EGR314-S-2026-202/EGR314-S-2026-202.github.io/docs/08-Resources/Resources.md

---
title: Resources
---

## CAD download files

### Concept Design

- [The Surveyor](../02-Concept-Design/CAD-models/EGR314-Surveyor.zip)
- [CropScout](../02-Concept-Design/CAD-models/A_WALLE.zip)

### 3D Printed Models

- [CropSCOUT Controller](../08-Resources/EGR314-Controller-Print.zip)
- [CropSCOUT Body](RoverBase.zip)
- [CropSCOUT Wheels and Temp/Humidity PCB Tower](PCB-Tower_T&H_W_Tower_CGE.SLDPRT)
- [CropSCOUT Full Assembly](CropScout%20ASMB_2023.zip)
- [Humidity Isolation Box](PCBholderbase.SLDPRT)
- [Humidity Isolation Box Lid](PCBLid.SLDPRT)
- [Temp Probe End Effector](endeff.SLDPRT)
- [PCB Retention Tab Large](bigcornerhold.SLDPRT)
- [PCB Retention Tab Small](cornerholdsmall.SLDPRT)
