EGR314-S-2026-202/EGR314-S-2026-202.github.io/docs/06-Prototype/Poster.pdf

### Embedded Systems Design Project II

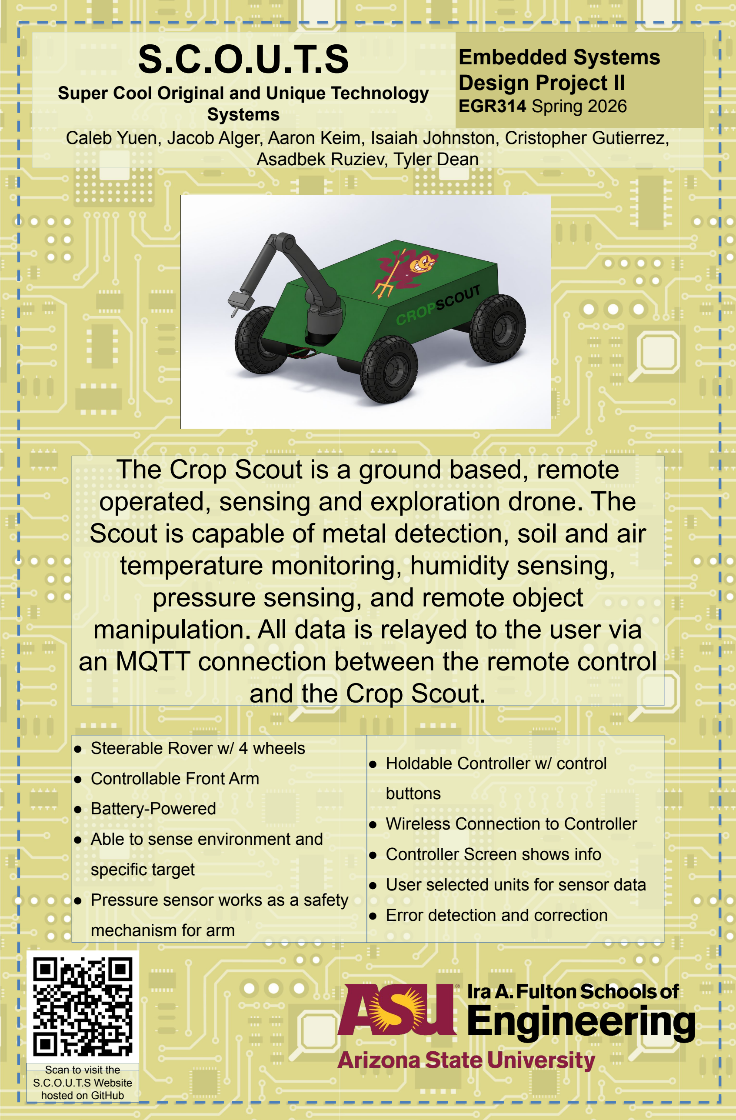
[picture p10: page 1]

EGR314 Spring 2026

# S.C.O.U.T.S

Super Cool Original and Unique Technology
Systems
Caleb Yuen, Jacob Alger, Aaron Keim, Isaiah Johnston, Cristopher Gutierrez, Asadbek Ruziev, Tyler Dean
- Steerable Rover w/ 4 wheels
- Controllable Front Arm
- Battery-Powered
- Able to sense environment and

specific target

- Pressure sensor works as a safety

mechanism for arm

## The Crop Scout is a ground based, remote operated, sensing and exploration drone. The Scout is capable of metal detection, soil and air

temperature monitoring, humidity sensing,

## pressure sensing, and remote object manipulation. All data is relayed to the user via an MQTT connection between the remote control

and the Crop Scout.

QR Code Here

Scan to visit the
S.C.O.U.T.S Website
hosted on GitHub
- Holdable Controller w/ control

buttons

- Wireless Connection to Controller
- Controller Screen shows info
- User selected units for sensor data
- Error detection and correction
