EGR314-S-2026-202/EGR314-S-2026-202.github.io/docs/05-Design-Review/design-review.md

---
title: Design Review
---

## External Design Review Team Presentation Video

Please view the video below to watch our design review where we cover our team organization, concept selection, product requirements, and team block diagram.

<iframe 
  width="800" 
  height="450"
  src="https://www.youtube.com/embed/wcsEIQijdIw"
  frameborder="0"
  allowfullscreen>
</iframe>

**External Design Review Team Presentation (Team 202) presented by Jacob Alger, Caleb Yuen, Aaron Kiem, Isaiah Johnston, Cristopher Gutierrez, Asadbek Ruziev & Tyler Dean**
