EGR314-S-2026-202/EGR314-S-2026-202.github.io/docs/04-Team-Block-Diagram/Team-Diagram.md

---
title: Block Diagram, Process Diagram, and Message Structure
---

## Team Block Diagram

Below is the Block Diagram we created as a team. We used the Daisy Chain format with 8-pin ribbon connectors to enable communication between all subsystems via UART and digital signals. There are two sections in our diagram: the rover section (on the right) and the controller section (on the left). It made sense to split the block diagrams this way, as the rover and the controller will be two separate modules that comprise the entire system. Both sections include Daisy Chain communication and will connect wirelessly via an MQTT server over Wi-Fi.

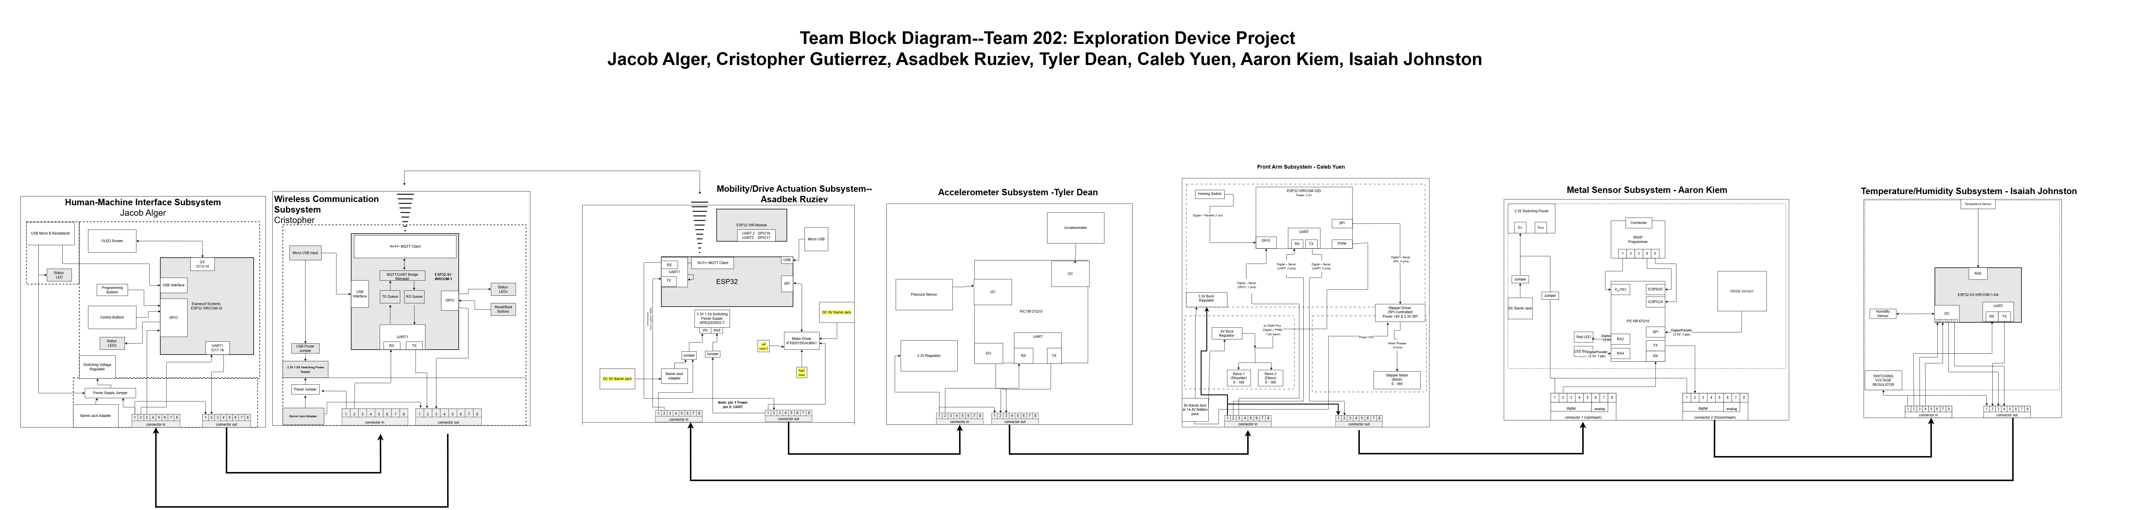
[picture p11: docs/04-Team-Block-Diagram/TBDV3.png]
Team Block Diagram


> You can view the Team Block Diagram as a PDF [here](TBDV3.draw.io.pdf) or via URL [here](https://viewer.diagrams.net/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)

## Communication Process Diagram

Below is the Communication Process Diagram, which details a couple of use cases for our system to help develop an understanding of how the user will interact with the device and how messages will be passed between subsystems. You can see that the user asks the controller to control the front arm and to change the temperature unit. This message is passed and acted upon by the system, going from system to system in the daisy chain. Then there is the loop section, which details what the rover is constantly doing independently of the user, such as using the pressure sensor to detect collisions with the arm.

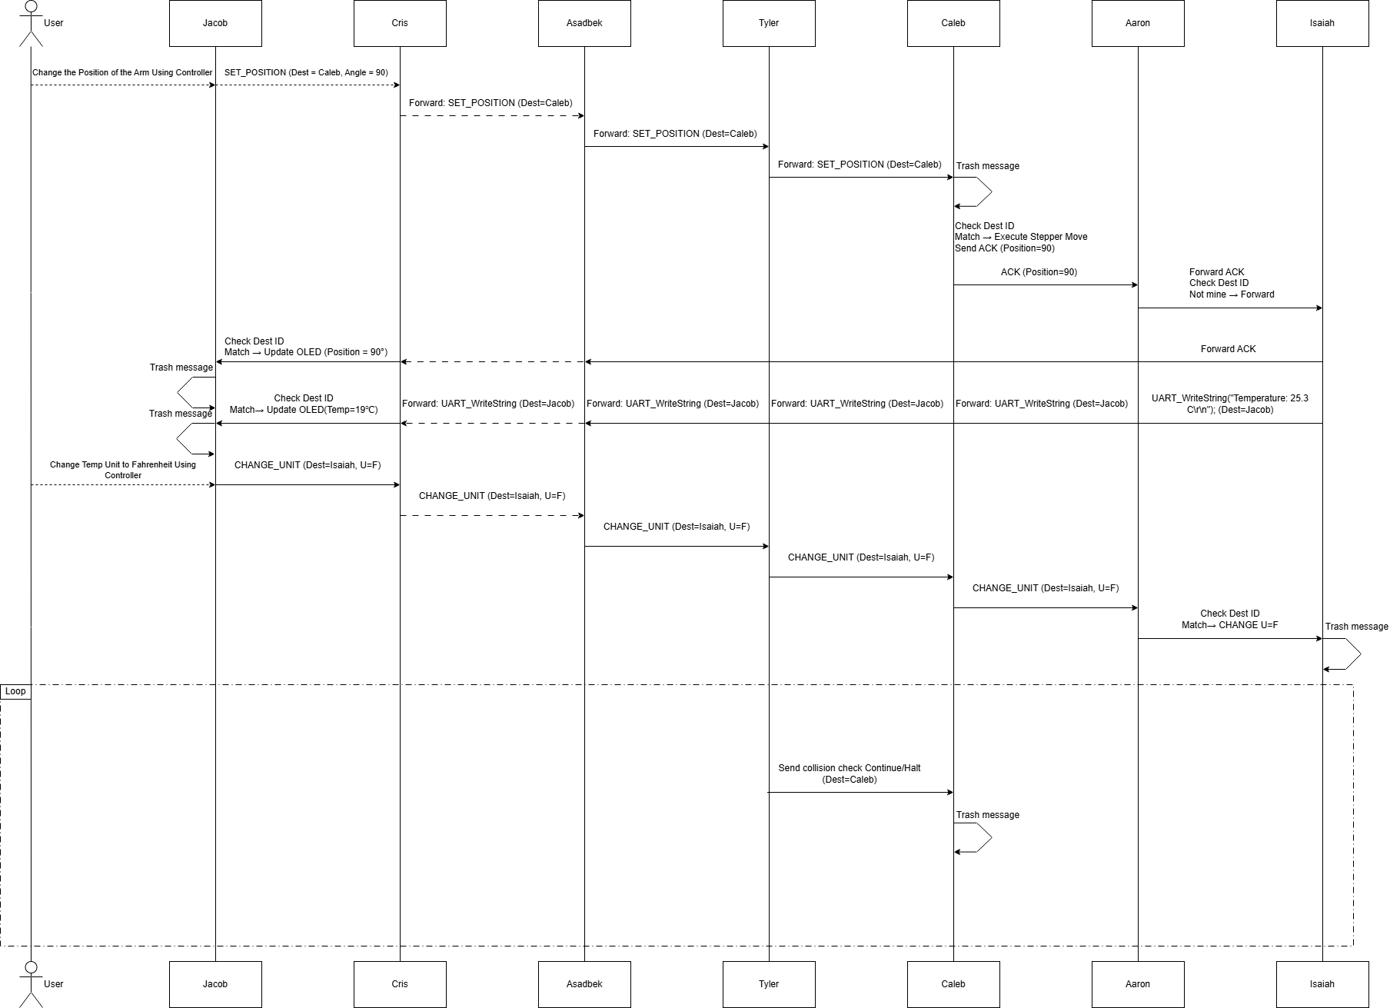
[picture p12: docs/04-Team-Block-Diagram/TSDV1.drawio.png]
Communication Process Diagram


> You can view the Communication Process Diagram as a PDF [here](TSDV1.drawio.pdf) or via URL [here](https://viewer.diagrams.net/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)

## Message Types
Below is a table of the types of messages that will be sent between our subsystems. Each type is given a number for better organization and understanding as to who is sending what kinds of messages.

| Number | Message Type | Description |
|---|---|---|
| 1 | Broadcast | The Broadcast Byte messages that go from anyone to everyone. |
| 2 | Wireless | Any message regarding wireless connection. |
| 3 | Wheels | Messages regarding the wheel subsystem. |
| 4 | Accelerometer  | Messages regarding the accelerometer/pressure sensor subsystem. |
| 5 | Arm | Messages regarding the front arm subsystem. |
| 6 | Temperature | Messages regarding the temperature sensor. |
| 7 | Humidity | Messages regarding the humidity sensor. |
| 8 | Metal | Messages regarding the metal detection subsystem. |

Below is a table detailing our team's full Application Programming Interface (API), showcasing every message with relevant information for each. Each message falls into one of the message types above. To learn more about the API, please review each teammate's individual datasheet and the "API" page for a comprehensive description.

| Source | Destination | Message Type | Message Name | Data Type | Message Data | Notes |
|---|---|---|---|---|---|---|
| HMI | Broadcast | 1 | Start Broadcast | String | Start | Sent to everyone; initiates system |
| HMI | Wheels | 3 | Wheel Drive Mode | String | F / B / R / L | Forward, Back, Right, Left |
| HMI | Pressure | 4 | Get Accelerometer | String | Read | Requests accelerometer reading |
| HMI | Arm | 5 | Arm Drive Mode | String | U / D / R / L | Up, Down, Right, Left |
| HMI | Metal Det.  | 8 | Metal Detector Read | String | Read | Requests metal detector reading |
| HMI | Temp/Hum. | 6 | Temperature Reading | String | Read | Requests temperature reading |
| HMI | Temp/Hum. | 6 | Temperature Unit Change | String | F / C | Switch between Fahrenheit and Celsius |
| HMI | Temp/Hum. | 7 | Humidity Reading | String | Read | Requests humidity reading |
| Communication | Wheels | 2 | BT Connection Check | String | check | Checks MQTT connection status |
| Temp/Hum. | HMI | 6 | Send Temperature | Float, String | -50–200, C / F | Two tokens; value and unit indicator |
| Temp/Hum. | HMI | 7 | Send Humidity | Float | 0–100 | Humidity percentage |
| Pressure | HMI | 4 | Send Accelerometer | Float | 0–100 | Accelerometer value |
| Pressure | Arm | 5 | Arm Clear Signal | Integer (8-bit)  | 00 / 01 | 00 = not clear, 01 = clear |
| Metal Det. | HMI | 8 | Metal Detector Relay | String | T / F | T = detected, F = not detected |
| Wheels | Comm. | 2 | BT Connection Reply | String | T / F | T = connected, F = not connected |
| Arm | HMI | 5 | Arm Position Ack. | Integer (16-bit) | -180–180 | Arm angle in degrees |
| Arm | HMI | 5 | Arm Status | String | Idle / Moving / Done / Halted | Current arm state |
| Arm | HMI | 5 | Arm Error | Integer (8-bit)  | 0–3 | Error code |

## Communication Sequence Functionality
The purpose of the communication diagram is to depict the interaction between the subsystems and the user's input. It satisfies the user's needs by handling the message input and passing it along the connection line. When a message reaches its designated subsystem, the subsystem interacts with the original input message and, if needed, outputs a response message, which is then sent down the chain to its targeted subsystem for output to the user.

An example of the communication structure follows this structure:
1) If the user presses a button on the HMI subsystem to raise the arm 
2) The HMI subsystem occupying the button would send a message out to the Arm subsystem, which is passed by other subsystems. 
3) The arm subsystem receives the message to raise its arm and would therefore raise its arm.
4) The arm subsystem trashes the original input message and outputs a position acknowledgment message targeting back to the HMI subsystem. 
5) That output message gets passed by the other subsystems and is received by the intended HMI subsystem.
6) The HMI subsystem would handle that message and therefore update its OLED screen for the user to see and trash the output message.
7) As a result, the user has the raise arm function carried out and is able to see verification that the OLED recognizes the position change.

## Message Structure
The design of the message outlines where the message came from (the source), who it's for (the destination), the variable associated with that message, the data type of that message, and the message related to that variable. A variable is connected with a colon, while additional variables are separated with a semicolon. A valid message would also start with AZ and end with YB. 

An example of a valid message would be AZthTV:F:75.256;TT:S:F;YB
- This is a message from the Temperature subsystem to the HMI subsystem, which calls for the temperature value as a float type and the temperature unit as a string with its corresponding values per variable.

## 5 Changes Post Software Proposal

1. We switched to MQTT instead of Bluetooth, so the Communication and Wheels subsystems had to both connect to the Wi-Fi, then the server, then the Comm system sent a handshake, which, once responded to by the Wheels, allowed the communication to start happening.

2. We changed the Start Broadcast to update the source in order to track where it was going. Originally, it would stay 'h' (from the HMI) the whole time, but now the HMI subsystem expects 't' to indicate that the message indeed reached the temperature/humidity subsystem.

3. The team experienced issues with reliably passing the broadcast message. A manual workaround was implemented to bypass the broadcast.

4. The arm subsystem sends position in steps, instead of degrees as originally planned.

5. All sensors were originally intended to have editable set points. This was never implemented.
