EGR314-S-2026-202/EGR314-S-2026-202.github.io/docs/01-Organization/Team-Organization.md

---
title: Team Organization
tags:
- tag1
---

## Team Charter

> S.C.O.U.T.S. is a group that focuses on communication, responsibility, and efficiency. We want to work together to make a high-quality product that we can all be proud of.

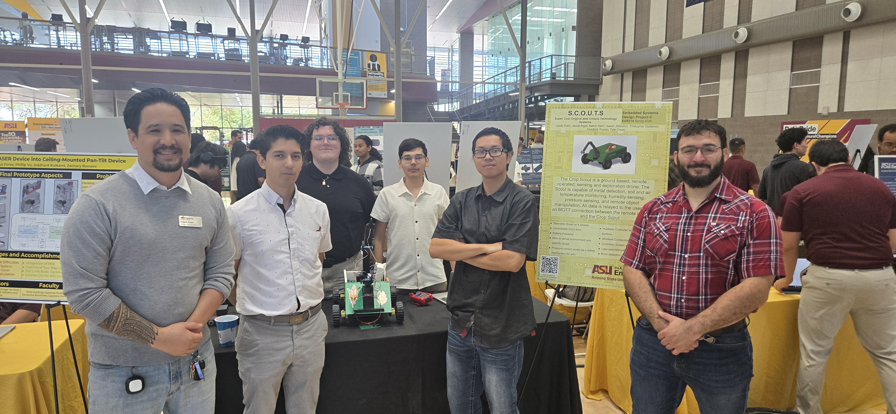
[picture p13: docs/01-Organization/Team_photo.jpg]
Team picture

>Team picture: From left to right: Caleb Yuen, Cristopher Gutierrez, Jacob Alger, Asadbek Ruziev, Aaron Kiem, Isaiah Johnston 

To create this Charter, the team sat down and discussed each individual's top 3 goals and qualities they want to achieve and demonstrate. Characterizing the Charter in this group setting ensured we all agreed on its content and the team's goals moving forward.

## Product Mission Statement

> S.C.O.U.T.S mission is to develop a modular exploration device that enables remote users to safely and expeditiously observe and interact with challenging environments through integrated sensing, actuation, and wireless communication.

To create this Mission Statement, we held a meeting to discuss the product's description and how we planned to achieve a successful outcome. We then boiled these ideas down to a single statement that accurately captures our desires for this product.

## Other Organizational Information

Other details about the organization structure of the team can be reviewed in ["Appendix: Team Organization Information."](https://egr314-s-2026-202.github.io/Appendix/01-Organization-Information/Append-Organization/)
