EGR314-S-2026-202/EGR314-S-2026-202.github.io/docs/06-Prototype/Showcase.md

---
title: Showcase
---

## Showcase Poster

Poster

>The pdf of the Poster can be dowloaded [*here*](Poster.pdf).

## Final Project Picture
Final Project Picture

## Showcase Video Demo

<p align="center">
  <iframe
    width="400"
    height="560"
    src="https://www.youtube.com/embed/YolZg2Wo9-o"
    frameborder="0"
    allowfullscreen>
  </iframe>
</p>

**Showcase demo narrated by Jacob Alger & Asadbek Ruziev**
