EGR314-S-2026-202/EGR314-S-2026-202.github.io/docs/04-Team-Block-Diagram/TBDV1.png

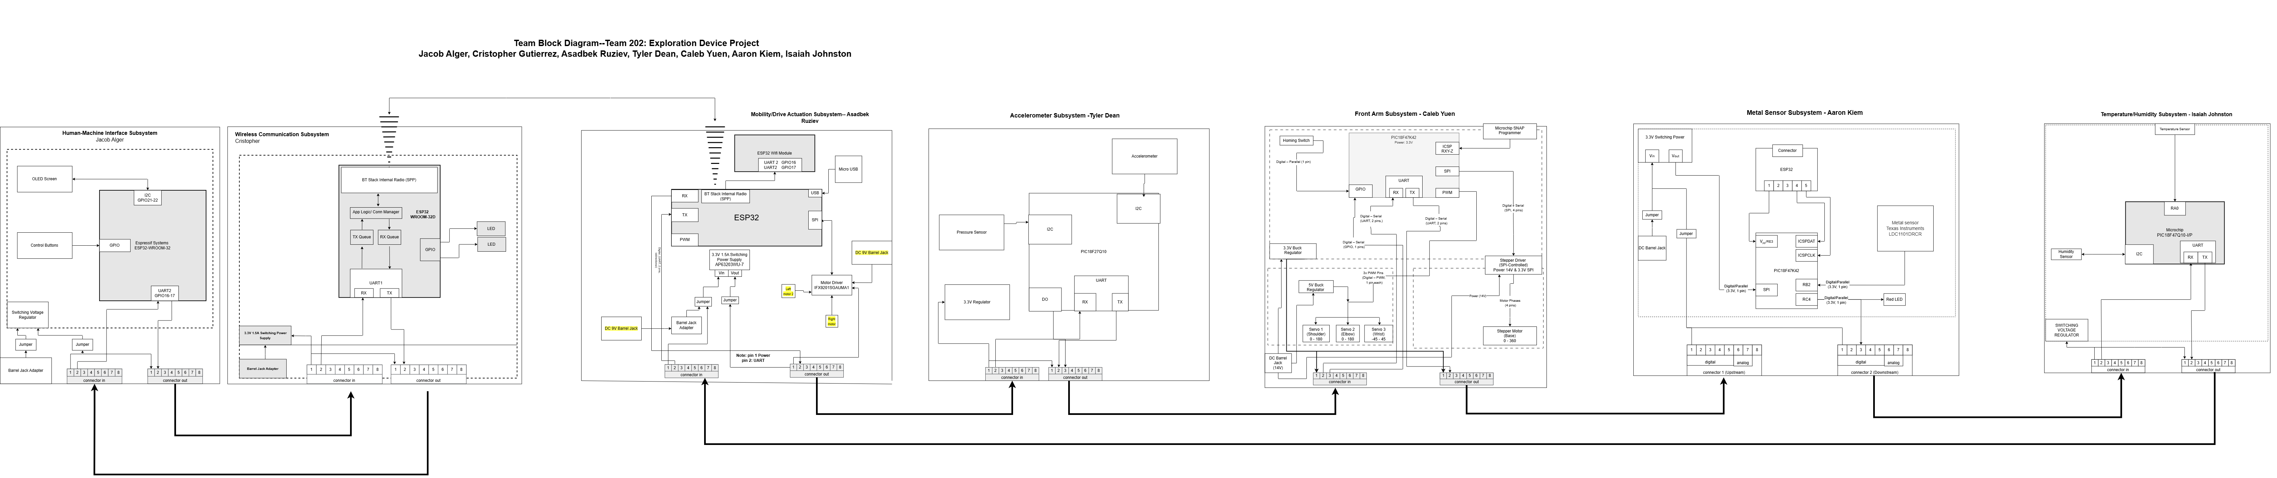
docs/04-Team-Block-Diagram/TBDV1.png
