EGR314-S-2026-202/EGR314-S-2026-202.github.io/docs/08-Resources/cornerholdsmall.SLDPRT

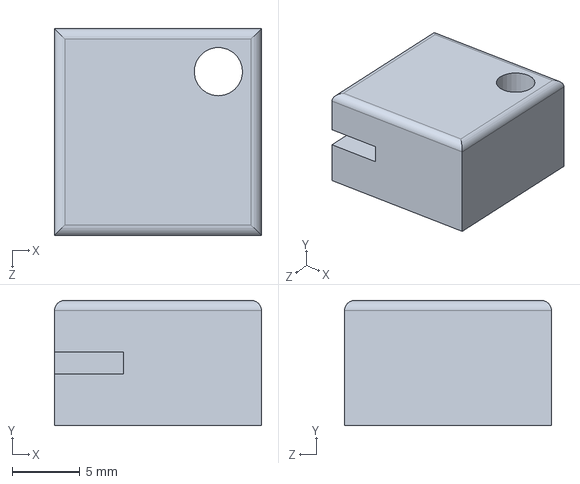
[picture p16: CAD file, 2026-05-05]
docs/08-Resources/cornerholdsmall.SLDPRT
15.2 x 9.22 x 15.2 mm
