EGR314-S-2026-202/EGR314-S-2026-202.github.io/docs/08-Resources/endeff.SLDPRT

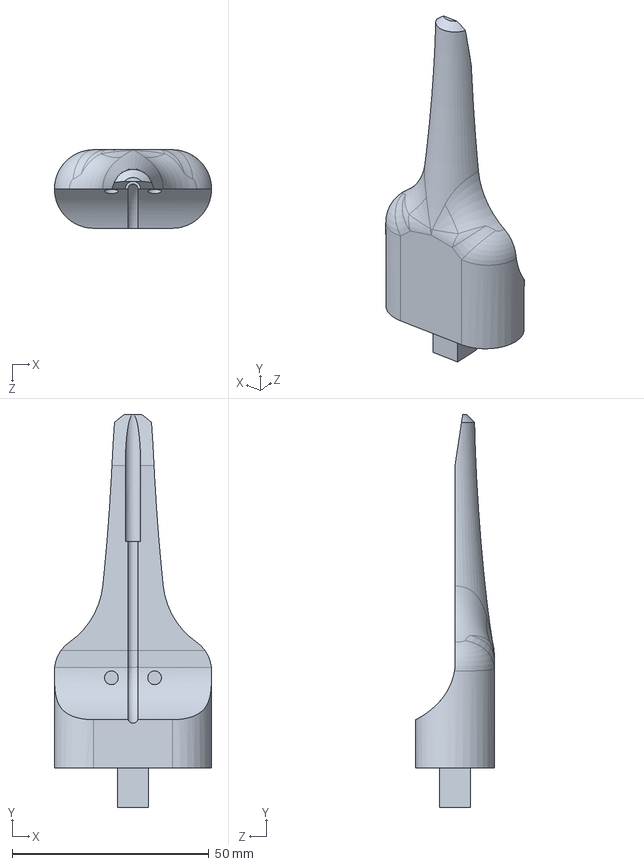
[picture p18: CAD file, 2026-05-05]
docs/08-Resources/endeff.SLDPRT
40.0 x 100.0 x 20.0 mm
