EGR314-S-2026-202/EGR314-S-2026-202.github.io/docs/08-Resources/PCBLid.SLDPRT

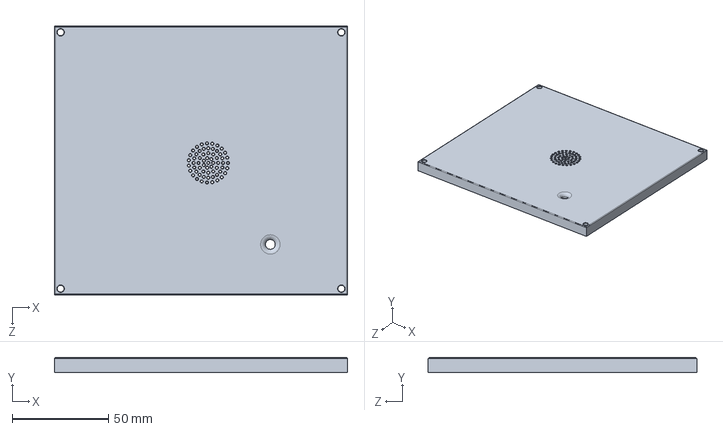
[picture p19: CAD file, 2026-05-05]
docs/08-Resources/PCBLid.SLDPRT
152.4 x 7.62 x 139.7 mm
