EGR314-S-2026-202/EGR314-S-2026-202.github.io/docs/08-Resources/PCBholderbase.SLDPRT

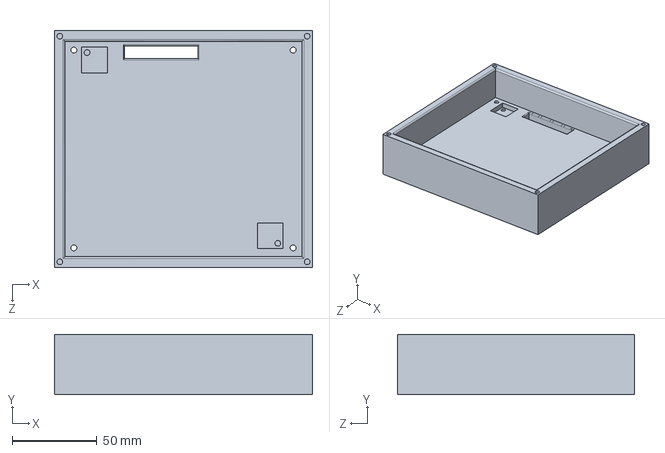
[picture p20: CAD file, 2026-05-05]
docs/08-Resources/PCBholderbase.SLDPRT
152.4 x 35.6 x 139.7 mm
