EGR314-S-2026-202/EGR314-S-2026-202.github.io/docs/08-Resources/PCB-Tower_T&H_W_Tower_CGE.SLDPRT

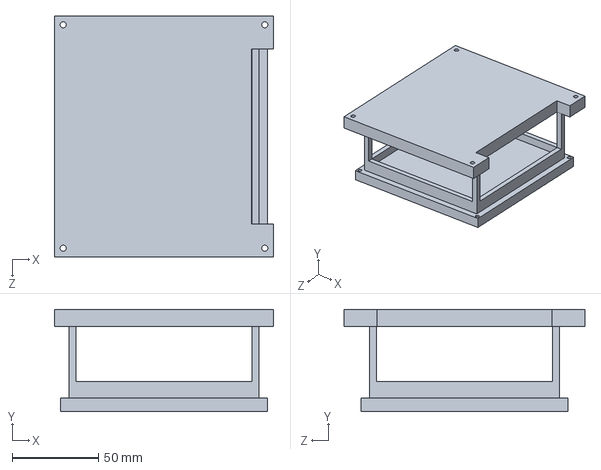
[picture p21: CAD file, 2026-05-05]
docs/08-Resources/PCB-Tower_T&H_W_Tower_CGE.SLDPRT
127.0 x 59.3 x 139.7 mm
