EGR314-S-2026-202/EGR314-S-2026-202.github.io/docs/02-Concept-Design/images/selected_C.pdf

# CROPSCOUT

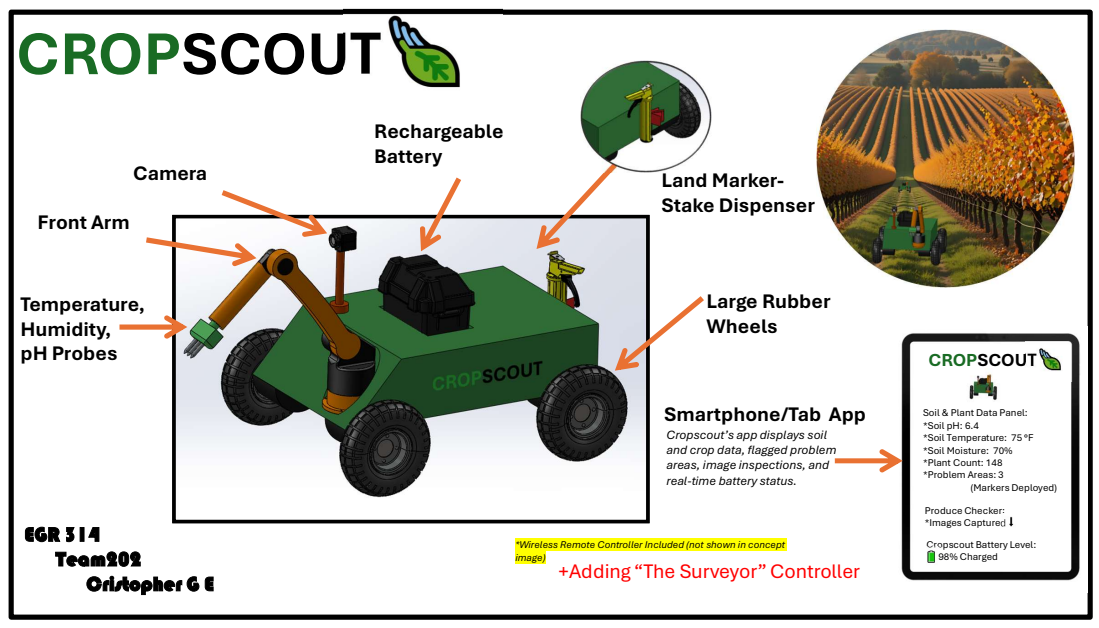
[picture p22: page 1]
CROPSCOUT; Camera; Rechargeable Battery; Land Marker-; Temperature, Humidity, pH Probes; Large Rubber Wheels; (Markers Deployed); EGR 314 Team202 Cristopher G E

Stake Dispenser Front Arm

Smartphone/Tab App
Cropscout’s app displays soil
and crop data, flagged problem
areas, image inspections, and
real-time battery status.

Soil & Plant Data Panel:
*Soil pH: 6.4
*Soil Temperature: 75 °F
*Soil Moisture: 70%
*Plant Count: 148
*Problem Areas: 3

Produce Checker:
*Images Captured
Cropscout Battery Level:
98% Charged

*Wireless Remote Controller Included (not shown in concept
image)
+Adding “The Surveyor” Controller
