EGR314-S-2026-202/EGR314-S-2026-202.github.io/docs/02-Concept-Design/images/EGR314-Surveyor-Concept.pdf

# THE SURVEYOR

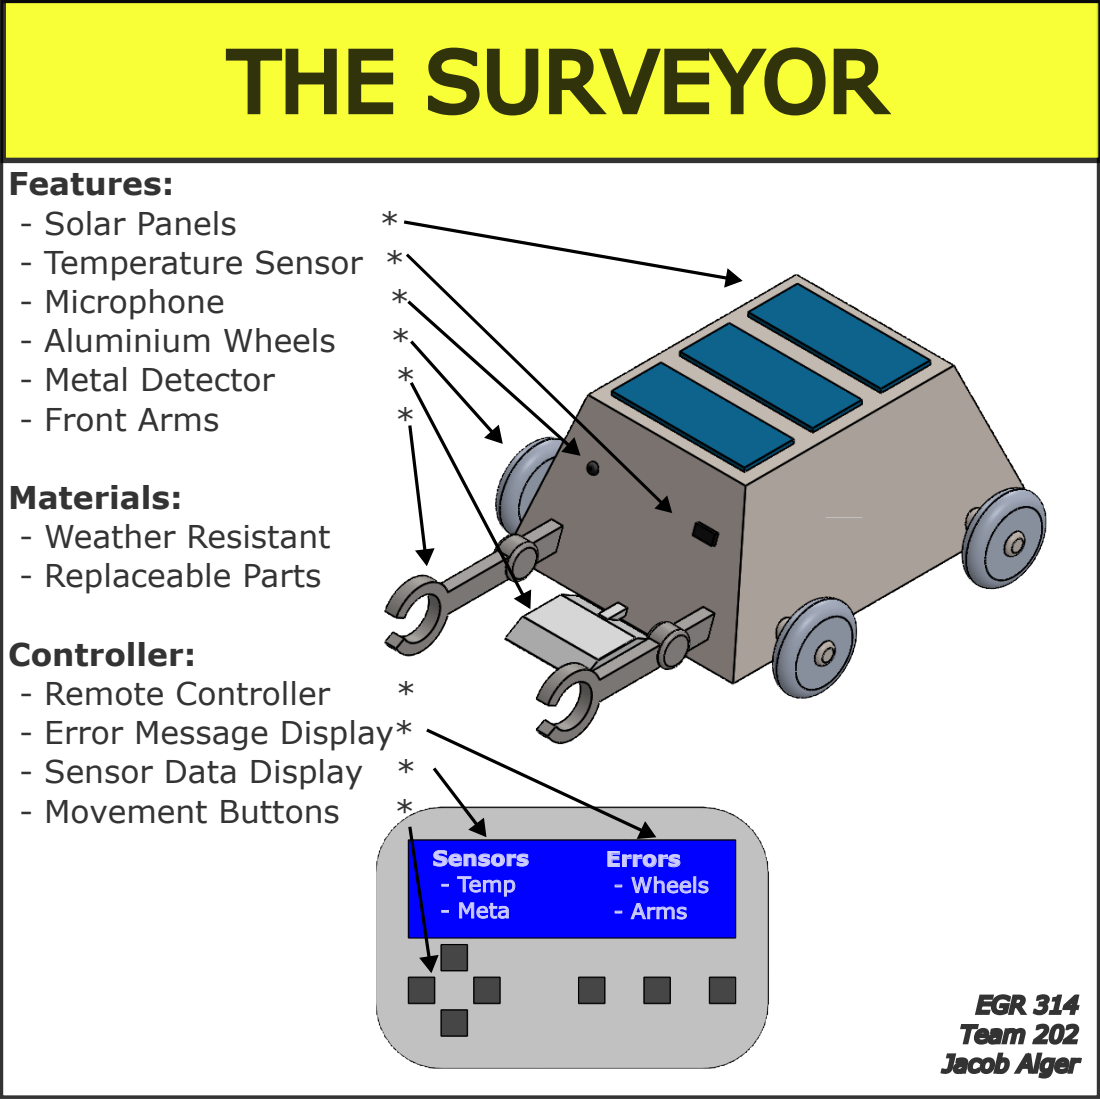
[picture p23: page 1]
Sensors - Temp - Meta; Errors - Wheels - Arms; Features:; - Solar Panels; - Temperature Sensor *; - Microphone; - Aluminium Wheels; - Metal Detector; - Front Arms; Materials: - Weather Resistant - Replaceable Parts; - Remote Controller; - Movement Buttons; EGR 314 Team 202 Jacob Alger

Controller:
- Error Message Display*
- Sensor Data Display *
