EGR314-S-2026-202/EGR314-S-2026-202.github.io/docs/04-Team-Block-Diagram/TBDV3.draw.io.pdf

# Wireless Communication Subsystem

# Cristopher

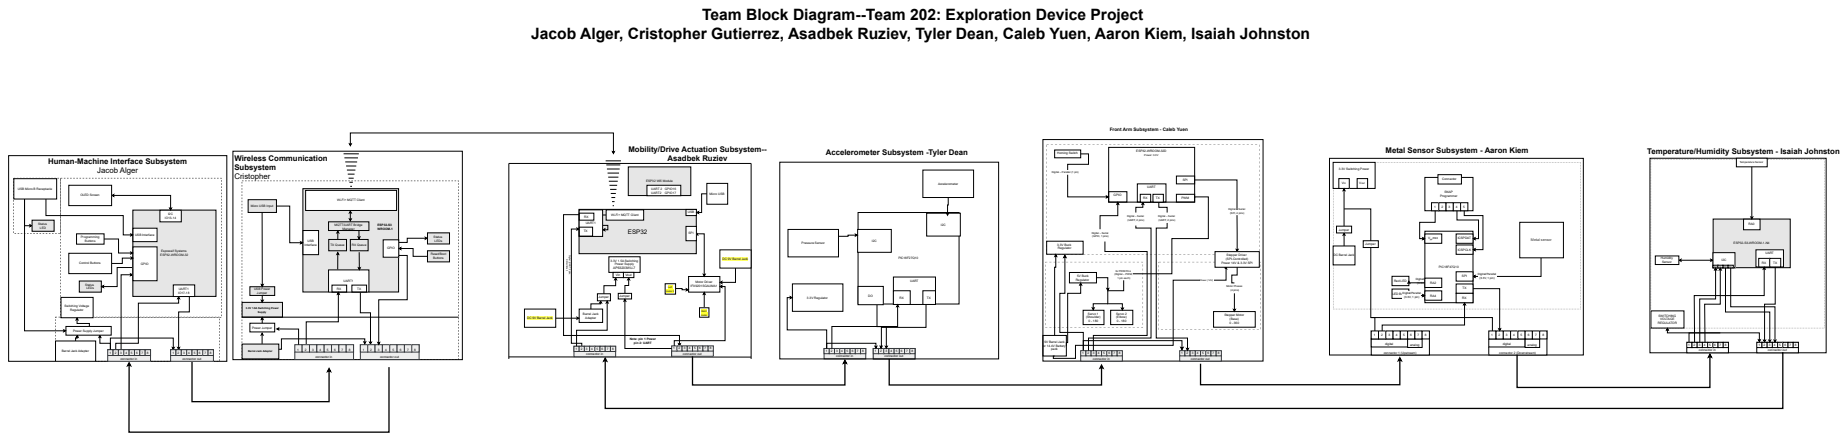
[picture p24: page 1]
Status LEDs; UART1 RX; ESP32-S3 WROOM-1; connector in; connector out 1; TX Queue; RX Queue; GPIO; Power Jumper; USB Interface; Power (14V); 3.3V Buck Regulator; Stepper Motor (Base) 0 - 360; Servo 1; (Shoulder) 0 - 180; Servo 2; (Elbow) 0 - 180; 3x PWM Pins; (Digital – PWM, 1 pin each); Motor Phases; (4 pins); 5V Buck Regulator; Homing Switch; connector out 1 2 3 4 5 6 7 8; ESP32-WROOM-32D; Power: 3.3V; UART RX; TX GPIO; SPI; PWM; Red LED; Digital/Parallel (3.3V, 1 pin); Humidity Sensor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

Team Block Diagram--Team 202: Exploration Device Project

Jacob Alger, Cristopher Gutierrez, Asadbek Ruziev, Tyler Dean, Caleb Yuen, Aaron Kiem, Isaiah Johnston

Front Arm Subsystem - Caleb Yuen

Mobility/Drive Actuation Subsystem-- Asadbek Ruziev

Accelerometer Subsystem -Tyler Dean

Metal Sensor Subsystem - Aaron Kiem

Temperature/Humidity Subsystem - Isaiah Johnston

Human-Machine Interface Subsystem

Digital – Parallel (1 pin)

USB Micro B Receptacle

ESP32 Wifi Module UART 2 GPIO16 UART2 GPIO17

Micro USB Input

Wi-Fi+ MQTT Client

digital - serial (UART, 2 pins)

Digital – Serial (UART, 2 pins)

Digital – Serial (SPI, 4 pins)

MQTT/UART Bridge Manager

Digital – Serial (GPIO, 1 pins)

Espressif Systems ESP32-WROOM-32

Reset/Boot Buttons

IFX9201SGAUMA1 Digital, (UART, 2 pins, bidirectional)

Stepper Driver
(SPI-Controlled) Power 14V & 3.3V SPI

DC Barrel Jack

3.3V 1.5A Switching Power Supply AP63203WU-7

Digital/Parallel (3.3V, 1 pin)

SDA SCL

USB Power Jumper

LED Button

Switching Voltage Regulator

3.3V 1.5A Switching Power Supply

Power Supply Jumper

Barrel Jack Adapter

9V Barrel Jack or 14.4V Battery pack
