EGR314-S-2026-202/EGR314-S-2026-202.github.io/docs/04-Team-Block-Diagram/TBDV2.drawio.pdf

# Team Block Diagram--Team 202: Exploration Device Project

Jacob Alger, Cristopher Gutierrez, Asadbek Ruziev, Tyler Dean, Caleb Yuen, Aaron Kiem, Isaiah Johnston

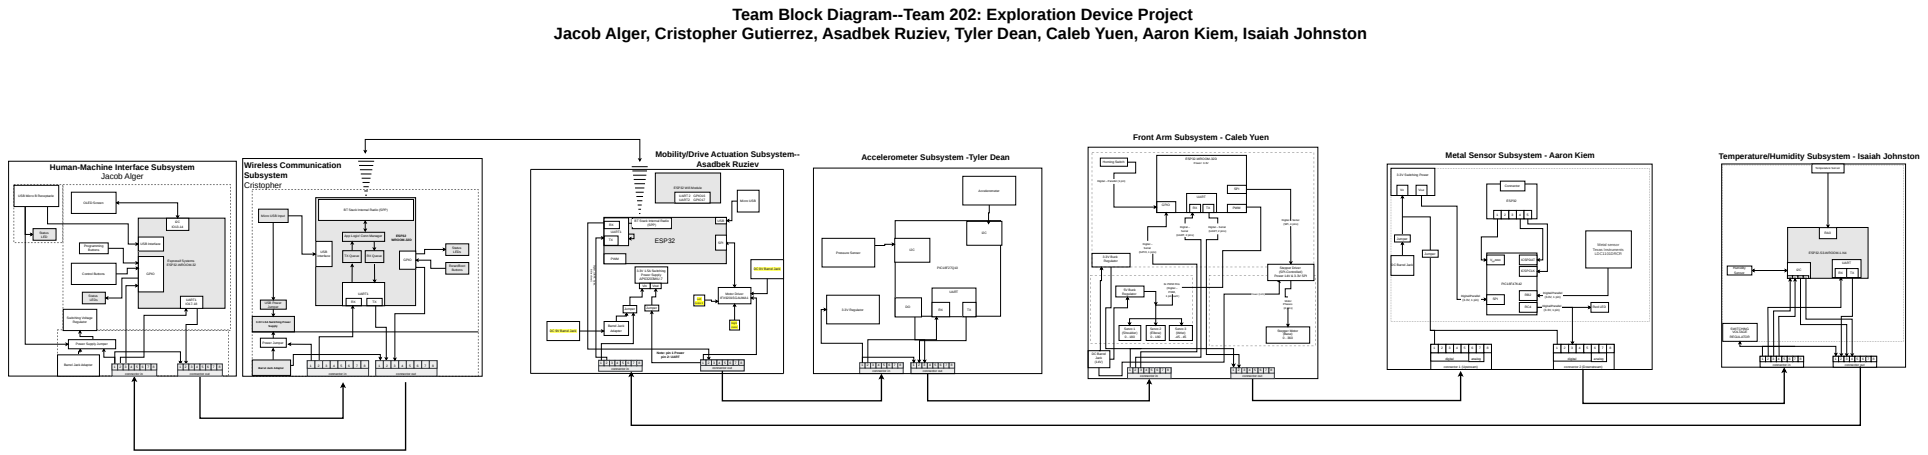
[picture p25: page 1]
Humidity Sensor; ESP32-S3-WROOM-1-N4; Temperature Sensor; UART; SWITCHING VOLTAGE REGULATOR; connector 1 (Upstream); digital; analog; 3.3V Switching Power; Vin; Vout; connector 2 (Downstream); PIC18F47K42; Vpp; ESP32; Connector; ICSPDAT; ICSPCLK; Jumper; Digital/Parallel (3.3V, 1 pin); Metal sensor Texas Instruments LDC1101DRCR; Digital/Parallel; (3.3V, 1 pin); SPI; Red LED; Metal Sensor Subsystem - Aaron Kiem; Temperature/Humidity Subsystem - Isaiah Johnston; connector in; connector out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

Front Arm Subsystem - Caleb Yuen

Mobility/Drive Actuation Subsystem--

Accelerometer Subsystem -Tyler Dean

Human-Machine Interface Subsystem

Digital – Parallel (1 pin)

USB Micro B Receptacle

BT Stack Internal Radio (SPP)

Micro USB Input

BT Stack Internal Radio

App Logic/ Conn Manager

Digital, (UART, 2 pins,

DC Barrel Jack

SDA SCL

DC 9V Barrel Jack

Power Supply Jumper

Note: pin 1 Power
pin 2: UART

Barrel Jack Adapter
