EGR314-S-2026-202/EGR314-S-2026-202.github.io/docs/04-Team-Block-Diagram/TSDV1.drawio.pdf

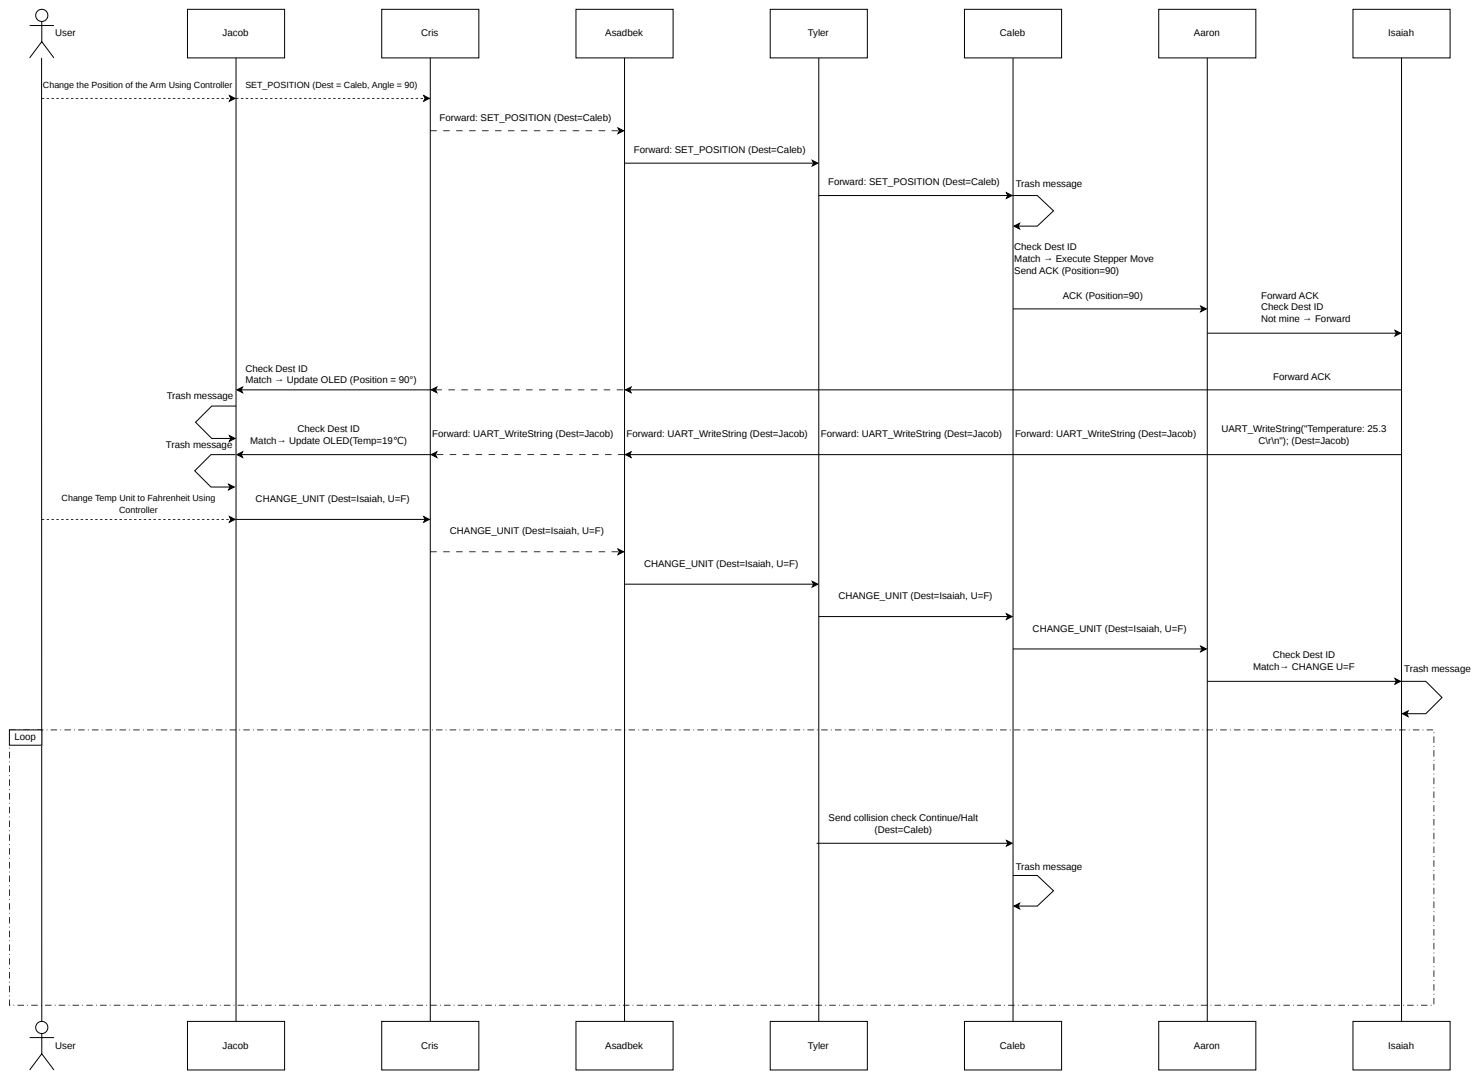
[picture p26: page 1]
User; Jacob; Cris; Asadbek; Tyler; Caleb; Aaron; Isaiah; ACK (Position=90); Forward ACK; UART_WriteString("Temperature: 25.3; C\r\n"); (Dest=Jacob) Forward: UART_WriteString (Dest=Jacob); Forward: UART_WriteString (Dest=Jacob); Forward: UART_WriteString (Dest=Jacob) Check Dest ID; CHANGE_UNIT (Dest=Isaiah, U=F); Controller; Trash message; Loop; (Dest=Caleb)

Change the Position of the Arm Using Controller

SET_POSITION (Dest = Caleb, Angle = 90)

Forward: SET_POSITION (Dest=Caleb)

Check Dest ID
Match → Execute Stepper Move
Send ACK (Position=90)

Not mine → Forward

Match → Update OLED (Position = 90°)

Match→ Update OLED(Temp=19℃)

Change Temp Unit to Fahrenheit Using

Match→ CHANGE U=F

Send collision check Continue/Halt
