EGR314-S-2026-202/EGR314-S-2026-202.github.io/(commit log)

2026-01-22 Add goal and audience sections to Design.md for clarity on device purpose and target users
2026-02-04 Update Product Mission Statement to reflect project focus on modular exploration device
2026-03-01 Update CropScout concept with new features
    Refined the CropScout design by replacing some original features with an accelerometer, pressure sensor, and metal detector for improved functionality.
2026-03-01 Added Surveyor CAD files
2026-05-02 Rename Showcase Demonstration to Prototype
2026-05-04 Home and Prototype Updates
2026-05-05 Added CAD models to Resources
2026-05-05 Update Resources.md with new CAD and model links
    Added new resources and updated existing links in the documentation.
2026-05-05 Update Resources.md with new CAD download links
    Added additional CAD files for various components.
2026-05-05 Update team diagram with arm subsystem changes
2026-05-05 Document sensor set points implementation status
