EGR314-S-2026-202/EGR314-S-2026-202.github.io/docs/06-Prototype/Poster.jpg

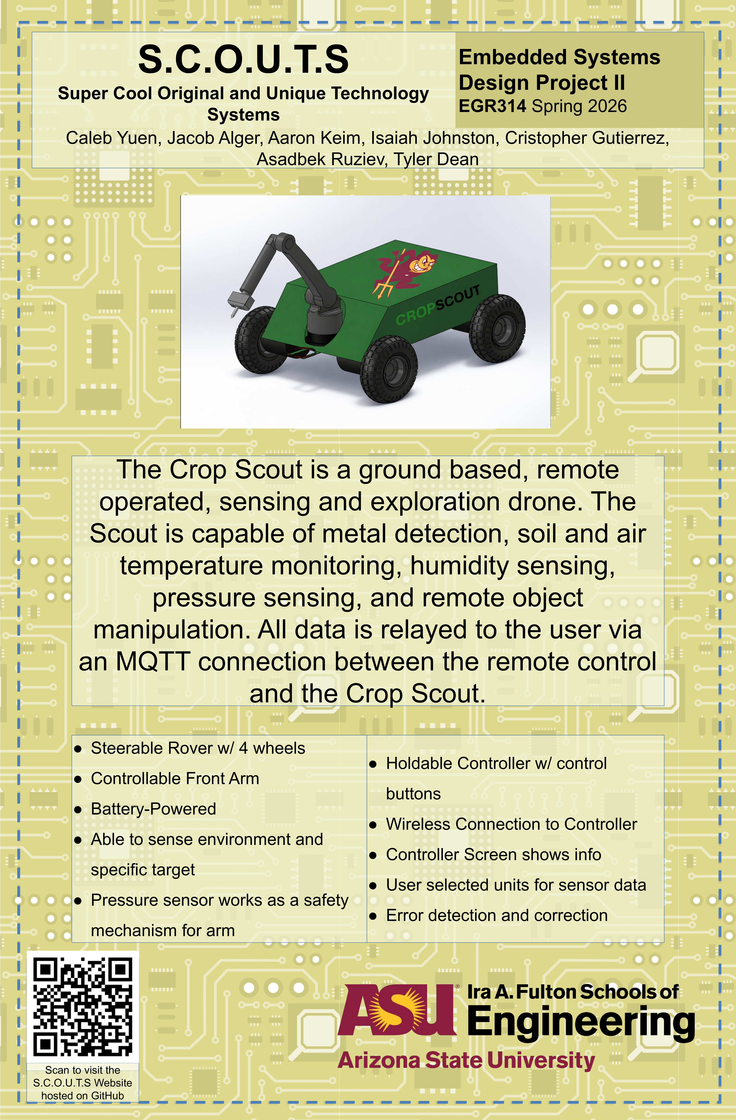
[picture p14: docs/06-Prototype/Poster.jpg]
docs/06-Prototype/Poster.jpg
